jang20050/web-deshboard_ai-notifier/docs/README.md

# docs — 문서와 증빙

수업 제출·포트폴리오용 기록을 모읍니다.

## 넣을 파일

| 파일 / 폴더 | 내용 |
|---|---|
| `spec.md` | 확정 사양: 목적, 사용자, 상태 정의, 진행도 규칙, 알림 규칙 |
| `context-of-use.md` | ISO 9241-210 사용 맥락: 사용자(관리자 1명), 과업, 환경(책상·같은 PC), 제약 |
| `usability-goals.md` | ISO 9241-11 측정 목표와 결과 (아래 예시) |
| `a11y-checklist.md` | WCAG 2.2 AA 점검 결과 (`dashboard/README.md` 체크리스트 기반) |
| `wiring/` | 배선도, 실물 배선 사진, 핀 연결표 |
| `test-log.md` | 정상·실패 장면 기록 (웹캠 인식 실패, 시리얼 끊김, bridge 꺼짐 등) |

## 사용성 목표 예시 (ISO 9241-11)
- **효과성:** 대시보드·장치를 보고 현재 상태를 10번 중 10번 맞힘
- **효율성:** 알림 후 확인까지 평균 30초 이내(자리에 있을 때), 대시보드에서 상태 파악 3초 이내
- **만족도:** SUS 설문 80점 이상, 부저가 거슬렸는지 기록

## 대화 원칙 점검 (ISO 9241-110)
과업 적합성 · 자기 설명성 · 기대 일치 · 학습 용이성 · 통제 가능성 · 오류 내성 · 사용자 몰입 — 항목별로 구현 근거를 한 줄씩 적기
