jang20050/web-deshboard_ai-notifier/(commit log)

2026-10-29 AI 작업 알림 장치: UNO 표시 장치, bridge, 대시보드, 제스처 확인
    - Arduino UNO: LCD1602·RGB·부저·버튼으로 진행도와 알림 표시 (부저 10회 반복)
    - bridge: Claude Code hook 수신, 진행도 추정, 시리얼 전송, 기록 저장
    - 웹 대시보드: AI 진행도·컴퓨터 부하·알림 장치 상태
    - Gesture: 웹캠 ok 제스처 YOLO26 분류 학습 사이트와 학습된 모델
    - XIAO ESP32S3 휴대폰 중계기 코드 (보드 연결 시험 전)
    - README에 아이디어·진행 순서·사진 정리
2026-10-30 docs: README에 Claude Hook 경로 에러 원인과 해결방안(ON/OFF) 추가
